algofoogle/raybox-zero/assets/tt07-wall-textures.png

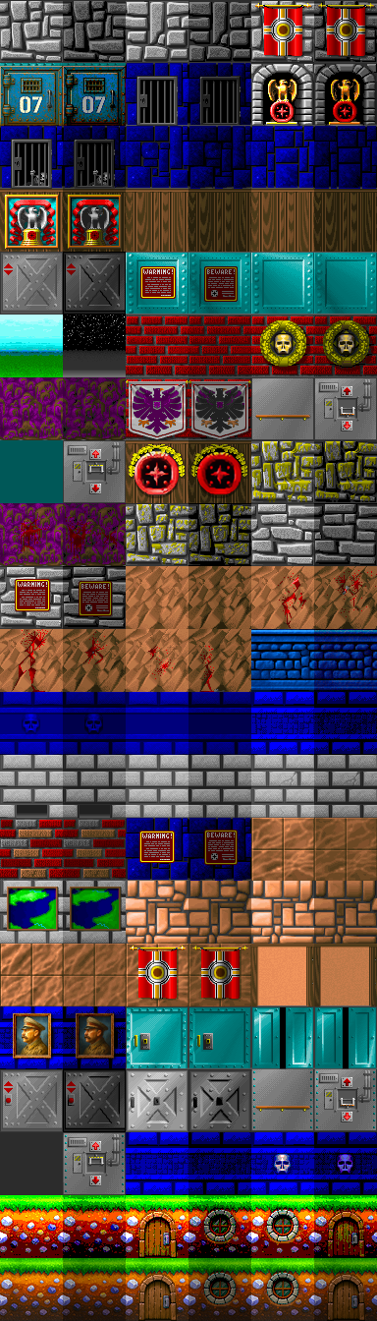
assets/tt07-wall-textures.png
