algofoogle/raybox-zero/src/rtl/helpers.v

`ifndef _HELPERS__H_
`define _HELPERS__H_

`define RGB     [5:0]
`define UQ6_9   [5:-9]  // UQ6.9, able to represent player position in range [0,64) with 1/512 resolution.
`define SQ2_9   [1:-9]  // SQ2.9, able to represent facing/vplane in range [-2.0,2.0) with 1/512 resolution.
`define WALL    [7:0]   // Wall IDs are 8 bits wide (though map cells are not necessarily).
`define WALLBITS 8

`define SPECIALWALL_DOORFRAME   3'd0

`endif//_HELPERS__H_
