algofoogle/raybox-zero/(commit log)

2023-08-08 Fix visible area gate
    [rbzero.v]
2023-08-13 Adding reciprocal (with LZC). Hits weird error (bug?) in 8bitworkshop: 'Error: extends width 64 != 32'
    [lzc.v, rbzero_top.v, reciprocal.v]
2023-08-16 Started adding fixed-point params, debug overlay, and view vectors (pov)
    [debug_overlay.v, fixed_point_params.v, map_overlay.v, pov.v, rbzero.v, vga_mux.v, wall_tracer.v]
2023-08-16 Starting to work on proper wall tracer
2023-08-16 Bringing in some of the tracer code from the original Raybox
2023-08-17 Adding most remaining tracer FSM logic. Some deliberate '@@@' stop points
2023-08-24 Fixing unsized constants to keep yosys happy
    [rbzero.v, wall_tracer.v]
2023-08-27 SPI logic in 'pov' to update vectors, sim support WIP
2023-08-28 Reworking pov to avoid multiple pov.ready drivers
    [pov.v]
2023-08-29 Option for explicit reset in wall_tracer
    [wall_tracer.v]
2023-08-30 Adding optional TRACE_STATE_DEBUG to visualise trace state on-screen
2023-08-30 Fix map size parameters
    [rbzero.v]
2023-09-01 test001: Merged TraceStep/TraceTest; commented out 'tex' logic.
2023-09-01 test002: Registered visualWallDist avoids post-subtraction
    [wall_tracer.v]
2023-09-05 (test009): pov SPI takes 74b: UQ6.9 for playerX/Y, SQ2.9 for others. Sim updated to suit
2023-09-05 sim: CTRL+arrows can scale facing/vplane before sending via SPI
2023-09-05 test010: Fixed point internal precision changed to Q9.10 from Q12.12
    [fixed_point_params.v, lzc.v, pov.v, wall_tracer.v]
2023-09-07 Basic texture u,v coords partly work. Need to fix initial when wall is bigger than screen
    [rbzero.v, row_render.v, sim_main.cpp, wall_tracer.v]
2023-09-07 sim: Fix Qm.n for inspecting internal signals
    [rbzero.v, sim_main.cpp]
2023-09-07 Adding de0nano wrapper for Quartus and DE0-Nano FPGA board
2023-09-07 Fixing de0nano TOP wiring and adding GPIO0 (later for Pi Pico SPI interface)
    [raybox-zero_de0nano.v]
2023-09-07 de0nano: Minor fixes to work with Quartus
    [pov.v, raybox-zero_de0nano.v, reciprocal.v, row_render.v, vga_sync.v]
2023-09-08 Adding PicoDeo interface for SPI
2023-09-08 Demo inputs to increment player position (overriding SPI)
2023-09-08 Tweaks for FPGA: Different reset view, demo mode interface, temporal dithering reinstated
    [pov.v, raybox-zero_de0nano.v]
2023-09-08 Implemented HBLANK and VBLANK outputs. Copied reset vectors into sim
    [rbzero.v, sim_main.cpp]
2023-09-08 Wall texture underflow clamp and possible 'floor leak' option for later use
    [rbzero.v, row_render.v]
2023-09-28 Fix for different Q values
    [fixed_point_params.v, lzc.v, rbzero.v, row_render.v, sim_main.cpp, wall_tracer.v]
2023-09-28 Added VINF (infinite wall) and VSHIFT (texV shift) SPI registers
2023-10-17 ew: Add top_ew_algofoogle wrapper, start wiring up
2023-10-17 ew: POC loading wall texture slices from SPI flash ROM
2023-10-20 ew: Mirror the texture and flip light/dark tint
    [rbzero.v]
2023-10-23 ew: Update de0nano SPI pinout
2023-10-24 ew: Switch de0nano to PLL for pixel_clock, try out 24.0MHz
2023-10-24 ew: Fix top_ew_algofoogle wiring
    [raybox-zero_de0nano.v, rbzero.v, top_ew_algofoogle.v]
2023-10-24 ew: Fixing a bunch of typos
    [top_ew_algofoogle.v]
2023-10-24 ew: Explicit reset checks to help with suspending all design activity
    [pov.v, rbzero.v, spi_registers.v]
2023-10-27 ew: Add power to top
2023-10-27 ew: Minor fixes to top module
    [top_ew_algofoogle.v]
2023-10-28 ew: Another gpout mux fix
    [top_ew_algofoogle.v]
2023-10-28 ew: Tiny fix to SNIPPET1_NoShare
    [SNIPPET1_NoShare.v]
2023-11-01 ew: Trying to fix late texture glitch
    [rbzero.v, wall_tracer.v]
2023-11-01 ew: Remove spi_regs SVerilog dependency; fix for de0nano
    [raybox-zero_de0nano.v, rbzero.v, spi_registers.v]
2023-11-01 ew: Connecting reg SPI for de0nano
2023-11-01 ew: Add trace debug overlay option back in
2023-11-01 ew: Minor fixes for un/registered outputs
    [top_ew_algofoogle.v]
2023-11-04 ew-fixspi: Reworking vec and reg SPI modules
    [pov.v, spi_registers.v]
2023-11-04 ew-fixspi: Tiny fix: Vec debug always on top
    [vga_mux.v]
2023-11-04 ew-fixspi: Rewriting reg SPI
    [spi_registers.v]
2023-11-04 ew-fixspi: Update top and SNIPPET2: new clock source, IO[11]
    [SNIPPET2_ShareIns.v, top_ew_algofoogle.v]
2023-12-03 gf180: Minor correction to top_raybox_zero_fsm
    [top_raybox_zero_fsm.v]
2023-12-03 gf180: Corrections to top_raybox_zero_fsm
    [top_raybox_zero_fsm.v]
2023-12-04 gf180: test14: Remove reset check from implied negedge block
    [rbzero.v]
2023-12-09 gf180-for-mux: Get rid of reset_alt
    [top_raybox_zero_fsm.v]
2024-03-30 Update v1.1 to v1.2 for newer de0nano GPIO-1 header wiring
2024-05-30 1.5-dev: Disable TRACE_STATE_DEBUG for now while targeting TT07
2024-05-30 1.5-dev: Trying to fix unknown (x) states in GL
    [lzc.v, wall_tracer.v]
2024-10-14 Trying to work around ORFS issue with $display()
    [reciprocal.v]
2024-10-27 Optional explicit texture memory reset for IHP GL sim
    [rbzero.v]
2024-11-01 NO_EXTERNAL_TEXTURES option to disable SPI textures
2024-11-01 LZC fix for ALT_FIXED_POINT_PARAMS
    [fixed_point_params.v, lzc.v, rbz_options.v]
2024-11-02 Add VSHIFT and LEAK control to sim
    [sim_main.cpp]
2024-11-02 Nearly fixed leak/under/overflow glitches
    [rbz_options.v, rbzero.v, row_render.v]
2025-06-08 Verilator sim: Frame step; basic keys info
2025-06-08 wall3bit: WIP: Tidyup, dividing wall ID fixes
    [rbzero.v, row_render.v, sim_main.cpp, spi_registers.v]
2025-06-09 wall3bit: WIP: Change SPI regs: use 8b command
2025-06-14 WIP: Groundwork prep for Verilator SPI support
2025-06-21 doors: WIP: Initial working implementation of 4 door registers
    4 doors can be placed in the map via SPI registers, given as X/Y
    coordinates, door 'pos' (8-bit value representing how open the door is),
    and wall ID. Includes automatic door frame.
2025-06-21 doors: WIP: Fix for when USE_DOORS is not defined
    [wall_tracer.v]
2025-06-21 doors: WIP: Fix; yosys can't extract bits from expression
    [wall_tracer.v]
2025-06-22 doors: WIP: Fix; yosys doesn't support arrayed ports
    [doors.v, map_overlay.v, rbzero.v, spi_registers.v, wall_tracer.v]
2025-07-05 WIP: Rework door test logic/regs; wall_id_resolver module
    Major rework of map cell check logic; door/wall priority and fallbacks
    SPI: CMD_TEXADDENA: specify which 8 TEXADDs apply for walls/doors
    Init/demo state includes all 4 doors
    Verilator-sim: CTRL+[ or ] will lock inc_px/py
    [doors.v, helpers.v, map_overlay.v, rbzero.v, row_render.v, sim_main.cpp, spi_registers.v, wall_tracer.v]
2025-11-23 doors: WIP: Door readmemb paths switch per VERILATOR
2025-11-24 doors: WIP: Fix inbuilt texture readmemb path
    [row_render.v, target_defs.v]
2025-11-24 doors: WIP: Fix for cocotb sim
    [row_render.v]
2026-07-13 doors: WIP: Minor lint fixes
    [map_overlay.v, wall_tracer.v]
2026-07-14 doors: WIP: Another tiny fix
    [vga_sync.v]
